saayuj/autonomous-mobile-robot/README.md

# Autonomous Mobile Robot

Built a four-wheeled robot from scratch with autonomous navigation, real-time positioning, and obstacle avoidance.

<div align="center">
  <video src="https://github.com/user-attachments/assets/52877d46-2691-4a65-99f3-b281364eb56b" width="700" />
</div>

---

## What It Does

- Autonomous navigation using HTC Vive positioning system
- Multi-sensor obstacle detection and avoidance
- WiFi control interface
- Closed-loop motor control with encoders

## Repository Structure

```
├── labs/              # Progressive exercises building up skills
│   ├── lab1/         # PWM and timers
│   ├── lab2/         # Digital I/O and sensors
│   ├── lab3/         # ADC and servo control
│   └── lab4/         # ESP32, WiFi, and motor control
├── final-project/    # Autonomous navigation system
└── results/          # Videos and images
```

---

## Final Project

Four-wheeled differential drive robot with Vive positioning, ToF sensors, and autonomous navigation.

**Hardware:** ESP32-S3, VL53L0X ToF sensors, dual motor drivers with encoders

<div align="center">
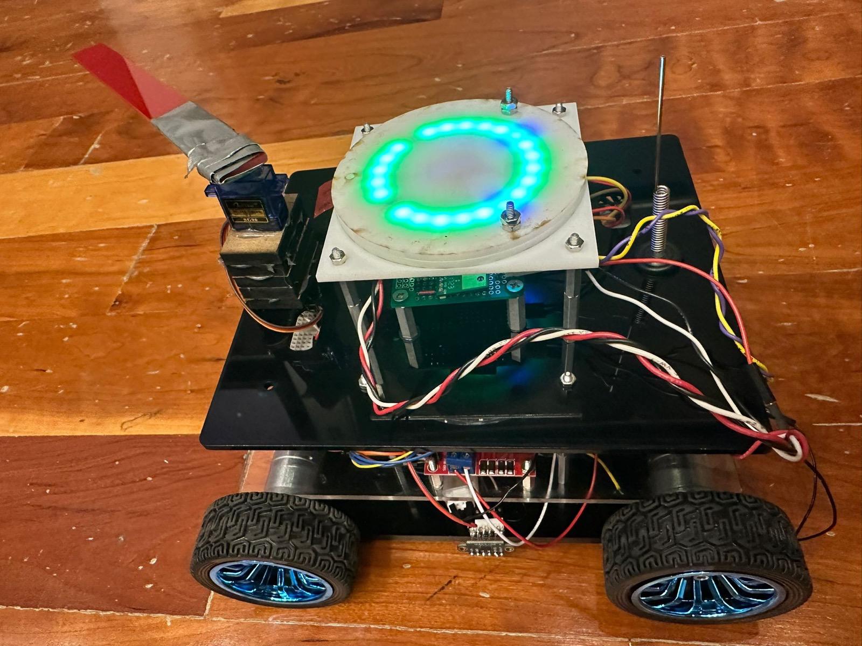
[picture p1: results/final-project/mobile_robot_1.jpeg]
  
</div>

<div align="center">
  <video src="https://github.com/user-attachments/assets/52877d46-2691-4a65-99f3-b281364eb56b" width="700" />
</div>

---

## Lab 4: Differential Drive Robot

Three-wheeled robot with ESP32 control and web interface.

<div align="center">
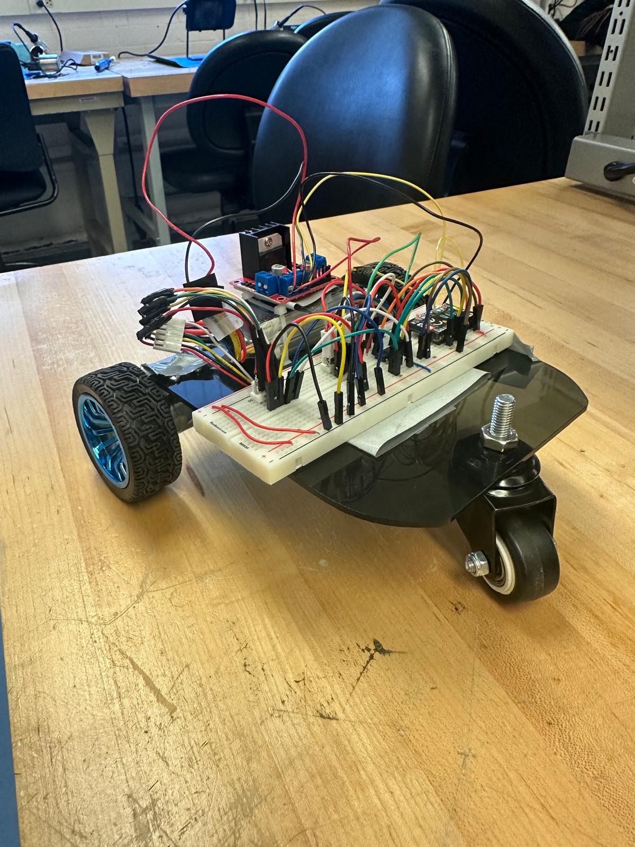
[picture p2: results/lab4/mobile_robot_basic.jpeg]
  
</div>

<div align="center">
  <video src="https://github.com/user-attachments/assets/ed081df5-c04b-4d58-bd4d-b600f9d34281" width="700" />
</div>

---

## Lab 3: Servo Control

Multi-axis servo control with potentiometers and ADC.

<div align="center">
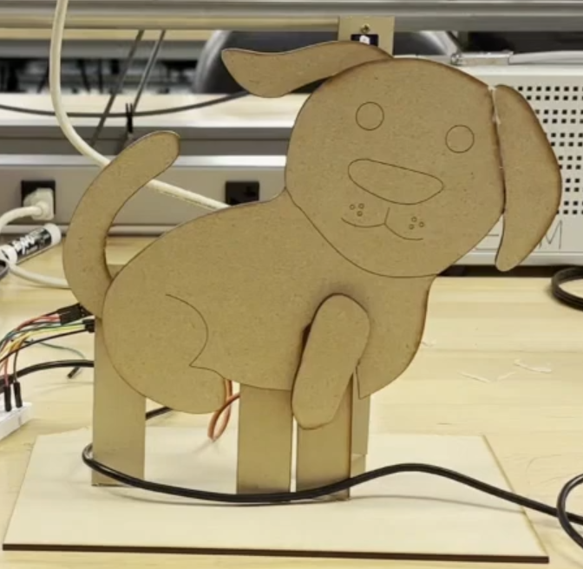
[picture p3: results/lab3/waldo.png]
  
</div>

<div align="center">
  <video src="https://github.com/user-attachments/assets/b562e0ac-89f8-4c6b-94f2-f533e8ffc787" width="700" />
</div>

---

## Tech Stack

**Hardware:** ATmega32U4, ESP32-S3, VL53L0X ToF sensors, rotary encoders, HTC Vive positioning  
**Software:** C/C++, Arduino, WiFi (UDP/HTTP), I2C, PD control

---

**Saayuj Deshpande**  
Fall 2024 • MEAM 5100
