saayuj/autonomous-mobile-robot/final-project/presentations/design_review_2.pdf

T E A M 2 6 : G I A D C O S T A , S A A Y U J D E S H P A N D E , S A M H I T H A V E D I R E

# MEAM 5100 Final Project

11/26/2024
DESIGN REVIEW 2

## A G E N D A

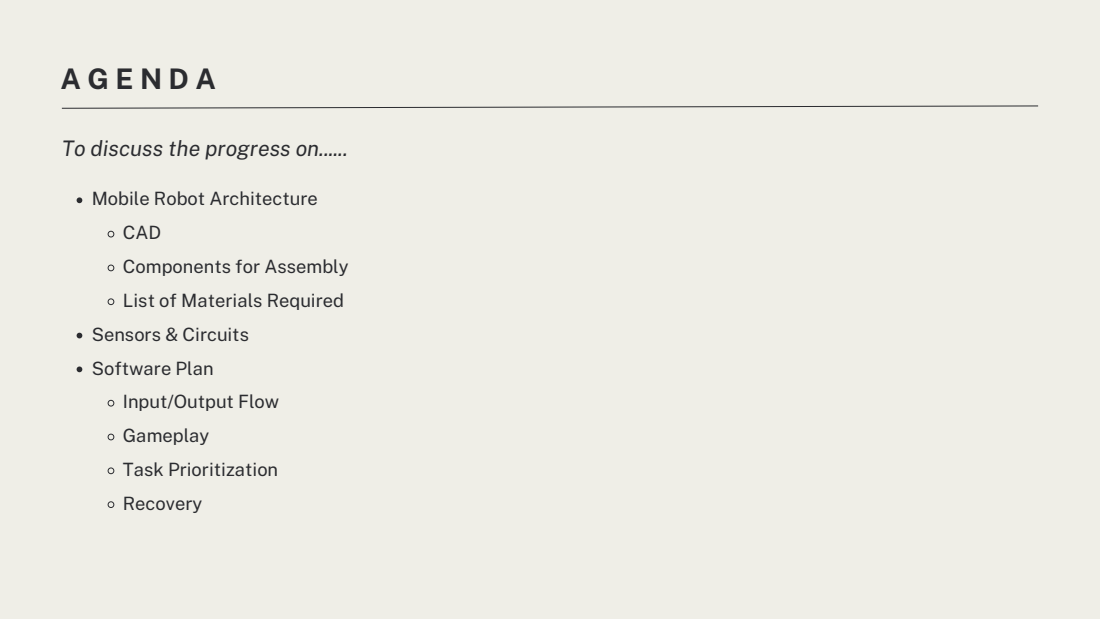
[picture p17: page 2]

To discuss the progress on......

Mobile Robot Architecture
CAD
Components for Assembly
List of Materials Required
Sensors & Circuits
Software Plan
Input/Output Flow
Gameplay
Task Prioritization
Recovery

## P R O P O S E D S C H E D U L E V S P R O G R E S S

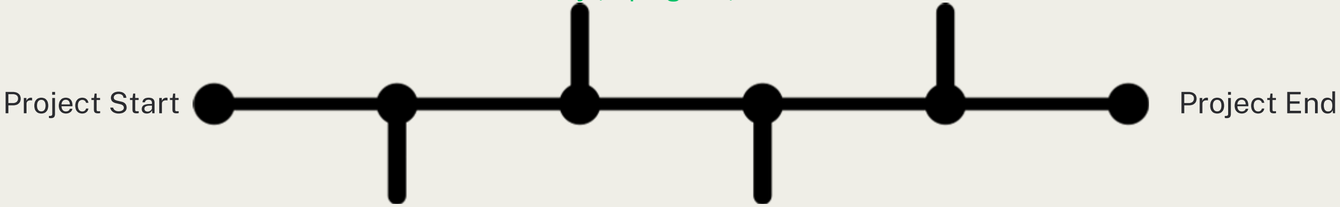
[picture p18: figure]
Project Start; Project End

WEEK 1
Ordering Components

(From DigiKey and Amazon)
PEFS Form submitted

WEEK 1
Fabrication and Assembly
Laser cutting of the chassis/components Assembly (In progress)

WEEK 2
Circuits and Code

(Vive, TOF sensing circuits, PID control for 4 wheel control)

WEEK 3
Testing and Assimilation

## M O B I L E R O B O T A R C H I T E C T U R E - B A S E P L A T E

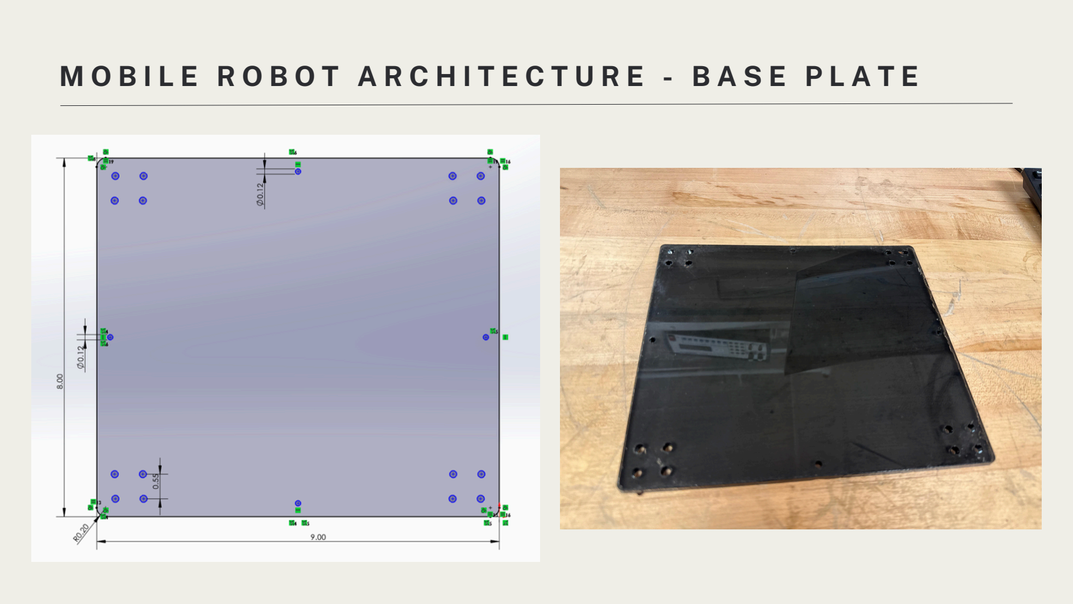
[picture p19: page 4]

## P E N D I N G W O R K

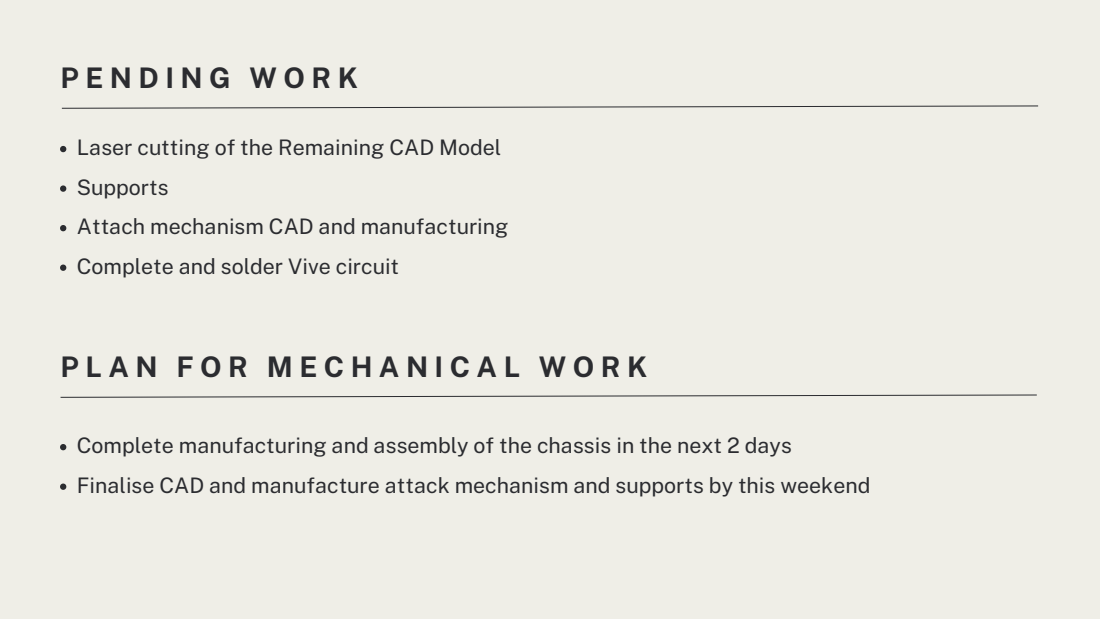
[picture p20: page 5]

Laser cutting of the Remaining CAD Model
Supports
Attach mechanism CAD and manufacturing
Complete and solder Vive circuit

Complete manufacturing and assembly of the chassis in the next 2 days
Finalise CAD and manufacture attack mechanism and supports by this weekend

## M O B I L E R O B O T A R C H I T E C T U R E

Key Components of Mechanical Design:-Major Upgrades

Differential Drive | Holonomic Drive
2 Motors | 4 Motors
3 Wheels | 4 Wheels Introduction of servo for Robotic Arm
LAB 4 | Final Project

NA

## M O B I L E R O B O T A R C H I T E C T U R E

We decided to shift from Differential Drive to Holonomic Drive based on the following issues we faced in Lab 4 :-

Steering inconsistencies
Absence of Diagonal/Omnidirectional movements

Serial No. | Description | Material/Component | Quantity
1 | Motors | Metal | 4
2 | Wheels | Plastic + Rubber | 4
3 | Chassis | Acrylic | 1
4 | Battery | LiPo | 2
5 | ToF Sensors | VL53L1X | 3
6 | RGB Sensors | VEML3328 | 3
7 | Vive Photosensors | PD70-01C/TR7 | 3
8 | Flex Sensor | Adafruit 182 | 2
9 | Whisker Switch | ME-8169 | 1
10 | Servo-Motor | SG90 | 1
11 | Microcontroller | ESP32-S3 | 2

## B I L L O F M A T E R I A L S

## C O M P O N E N T S

Localization:-; HTC Vive; PD70-01C/TR7 IR Photodiode

Fig: PD70-01C/TR7 from DigiKey

Wall sensing:-
VL53L1X Time of Flight (ToF) sensor
4m range

Fig: VL53L1X from DigiKey

## C O M P O N E N T S

Contact sensing:-
4.4in Flex Sensor

Fig: Flex sensor from Adafruit

Colour sensing:-
VEML3328 RGB sensor


Fig: VEML3328 from DigiKey

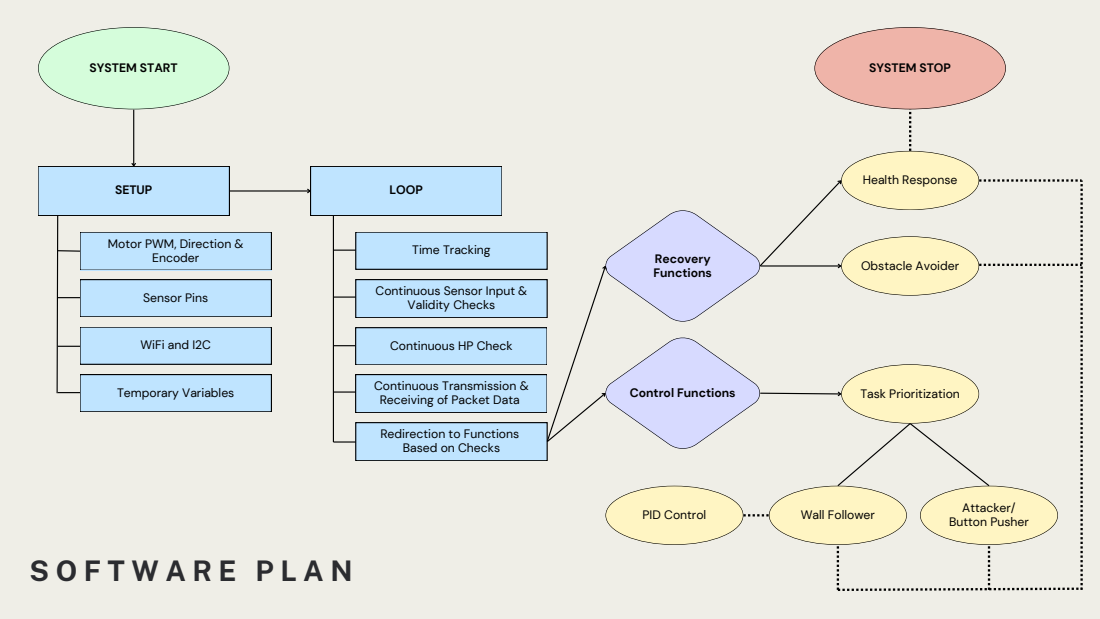
[picture p21: page 11]
SETUP; SYSTEM START; Sensor Pins; WiFi and I2C; Temporary Variables; Time Tracking; Recovery Functions; LOOP; Control Functions; Obstacle Avoider; Task Prioritization; Wall Follower; Attacker/ Button Pusher; Health Response; SYSTEM STOP; PID Control

Motor PWM, Direction &
Encoder

Continuous Sensor Input &
Validity Checks

Continuous HP Check

Continuous Transmission &
Receiving of Packet Data

Redirection to Functions
Based on Checks

## P L A N F O R T E S T I N G

1.Integrating Vive and ToF sensor inputs

2.Performing wall following

3.Integrating RGB sensor input

4.Reaching button targets on nexus and towers + Pushing the buttons

5.Integrating obstacle avoidance

6.Following another bot + Attacking functionality

## S U M M A R I Z N G O U R P R O G R E S S

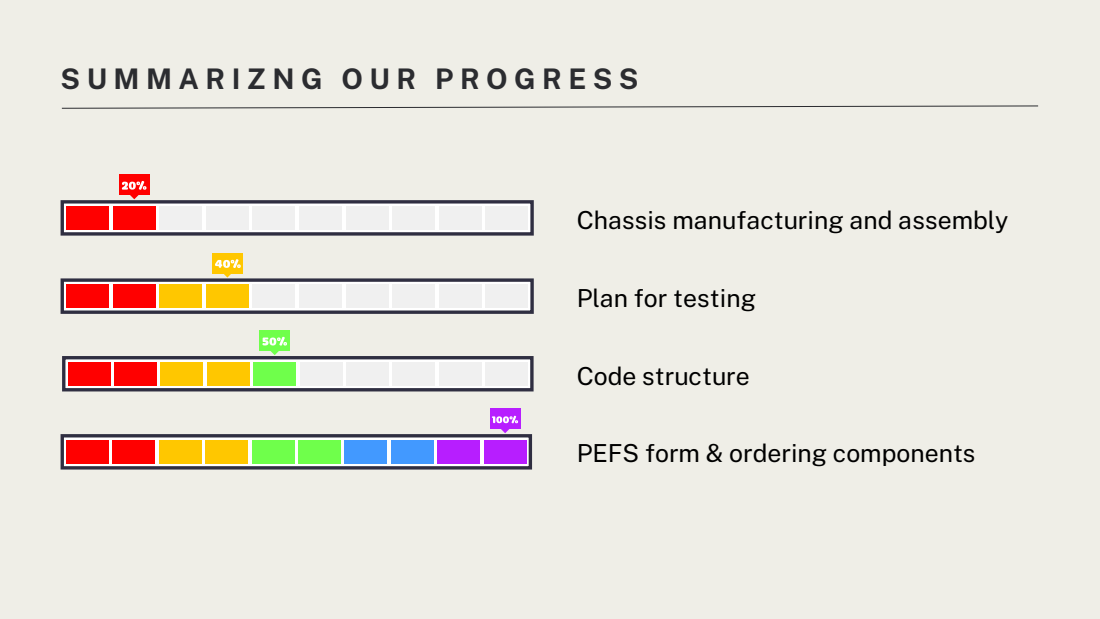
[picture p22: page 13]
Code structure

Chassis manufacturing and assembly

Plan for testing

PEFS form & ordering components

## C R I T I C A L P A R T S O F T H E P R O J E C T

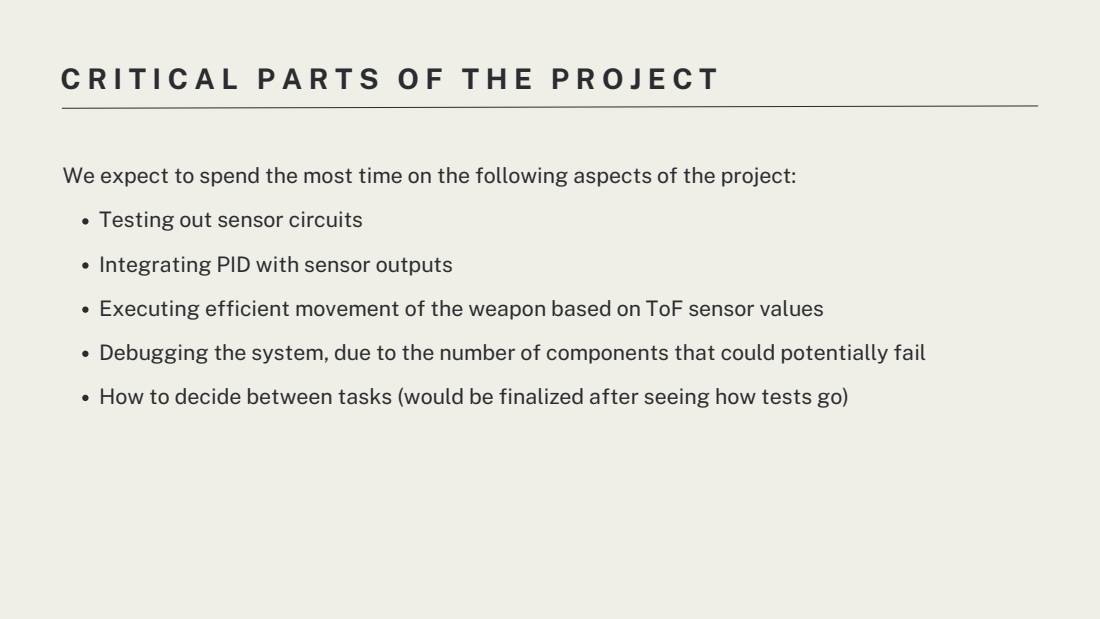
[picture p23: page 14]

We expect to spend the most time on the following aspects of the project:
Testing out sensor circuits
Integrating PID with sensor outputs
Executing efficient movement of the weapon based on ToF sensor values
Debugging the system, due to the number of components that could potentially fail
How to decide between tasks (would be finalized after seeing how tests go)

# Thank You
