saayuj/autonomous-mobile-robot/results/final-project/mobile_robot_2.jpeg

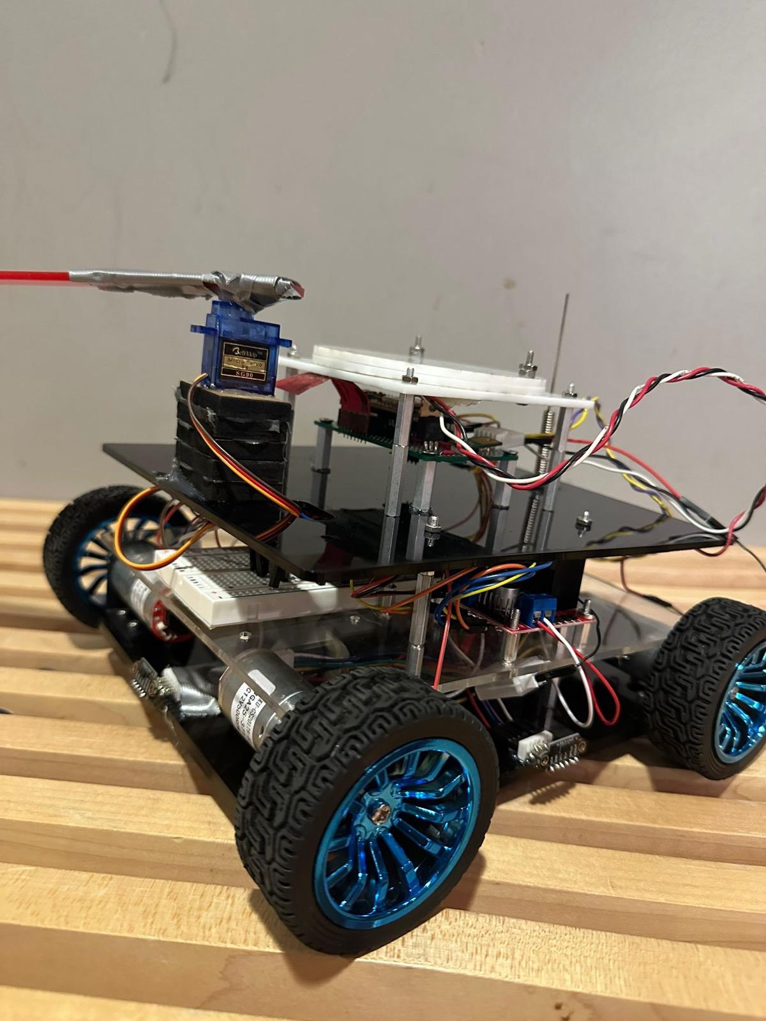
results/final-project/mobile_robot_2.jpeg
